albizon/ER4_Accordeur/README.md

# Accordeur de Guitare
## Projet Etude et Réalisation - Semestre 4
## IUT de Nantes - GEII2 - PEI - 2016/2017
### METAYER Simon & BIZON Alexis
### Status : En cours de développement
### Dernière version stable : V1.0
### Version en cours : v2.0

#### Présentation
Le projet consiste à réaliser un accordeur de guitare indiquant par l'intermédiaire de différentes leds si la note est trop haute, juste ou trop basse.</br>
La plateforme retenue pour réaliser cet accordeur est composée d'un SAMD21 de chez Atmel comportant un coeur arm cortex M0+, elle se nomme **SAMD21 Xplained Pro**</br>

####Version 1
La version 1 du projet permet d'accorder des signaux carrés à la note la plus proche avec une erreur définissable à la compilation</br>

####Version 2
La version 2 du projet permet d'accorder une guitare électrique directement reliée au micro-controleur par l'intermédiaire d'un connecteur jack</br>
