albizon/ER4_Accordeur/Code/TP-info2/touches-du-piano.jpg

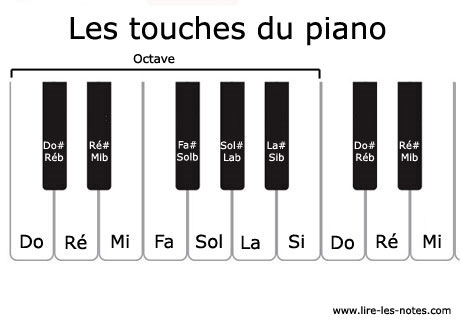
Code/TP-info2/touches-du-piano.jpg
