albizon/ER4_Accordeur/(list of files, drawings)

Other design files:
PCB/AccordeurV2.0.pdsprj
