albizon/ER4_Accordeur/Code/TP-info2/userMemory/src/externalFlashMemory.c

/*
* Accordeur de Guitare
* Authors : METAYER Simon & BIZON Alexis
* Created Date : 02/02/17
* Version : 2.0
*/

#include "externalFlashMemory.h"




/*void initExternalFlash(void)
{
	init_spi(SERCOM_FOR_EXTERNALFLASH, ARGS_FOR_EXTERNALFLASH_INIT);
	initCircuitFlash(0);
}




uint32_t reallocExternalFlash(uint32_t address, uint32_t lastSize, uint32_t newSize)
{
	freeExternalFlash(address, lastSize);
	return allocExternalFlash(newSize);
}*/
