albizon/ER4_Accordeur/Code/TP-info2/userMemory/src/externalRamMemory.c

/*
* Accordeur de Guitare
* Authors : METAYER Simon & BIZON Alexis
* Created Date : 02/02/17
* Version : 2.0
*/

#include "externalRamMemory.h"




/*void initExternalRam(void)
{
	#ifndef USE_SAMD21
	uint32_t args[14] = ARGS_FOR_EXTERNALRAM_INIT;
	initSpi(SERCOM_FOR_EXTERNALRAM, args);
	#endif
	initCircuitRam();
}




uint32_t reallocExternalRam(uint32_t address, uint32_t lastSize, uint32_t newSize)
{
	freeExternalRam(address, lastSize);
	return allocExternalRam(newSize);
}*/
