albizon/ER4_Accordeur/Code/TP-info2/userMemory/src/genericMemory.c

/*
* Accordeur de Guitare
* Authors : METAYER Simon & BIZON Alexis
* Created Date : 02/02/17
* Version : 2.0
*/


#include "genericMemory.h"

/*void _4BytesTo1Byte(uint32_t in, uint8_t *out)
{
	out[0]=in&(0xFF<<0);
	out[1]=in&(0xFF<<8);
	out[2]=in&(0xFF<<16);
	out[3]=in&(0xFF<<24);
}

uint32_t _1BytesTo4Byte(uint8_t *in)
{
	return (in[3]<<24)|(in[2]<<16)|(in[1]<<8)|(in[0]<<0);
}

void writeMemory(uint32_t address, uint32_t val, uint8_t device)
{
	switch(device){
		case USE_INTERNAL_RAM :
			&address = val;
		break;
		case USE_EXTERNAL_FLASH:
			writeExternalFlash_uint32(address, val);
		break;
		case USE_INTERNAL_FLASH:
		
		break;
		case USE_EXTERNAL_RAM:
			writeExternalRam_uint32(address, val);		
		break;
		default :
		
		break;
	}
}

uint32_t readMemory(uint32_t address, uint8_t device)
{
	uint32_t tmp =0;
	
	switch(device){
		case USE_INTERNAL_RAM :
			tmp = &address;
		break;
		case USE_EXTERNAL_FLASH:
		 tmp = readExternalFlash_uint32(address);
		break;
		case USE_INTERNAL_FLASH:
			tmp = 1;
		break;
		case USE_EXTERNAL_RAM:
		 tmp = readExternalRam_uint32(address);
		break;
		default :
		 tmp = 1;
		break;
	}
	
	return tmp;
}

uint32_t allocMemory(uint32_t size, uint8_t device)
{
	uint32_t tmp =0;
	
	switch(device){
		case USE_INTERNAL_RAM :
			tmp = malloc(size*sizeof(uint32_t));
		break;
		case USE_EXTERNAL_FLASH:
			tmp = allocExternalFlash(size);
		break;
		case USE_INTERNAL_FLASH:
			tmp = 1;
		break;
		case USE_EXTERNAL_RAM:
			tmp = allocExternalRam(size);
		break;
		default :
			tmp = 1;
		break;
	}
	
	return tmp;
}

void freeMemory(uint32_t address, uint32_t size, uint8_t device)
{
	switch(device){
		case USE_INTERNAL_RAM :
			free(address);
		break;
		case USE_EXTERNAL_FLASH:
			freeExternalFlash(address, size);
		break;
		case USE_INTERNAL_FLASH:
		
		break;
		case USE_EXTERNAL_RAM:
			freeExternalRam(address, size);
		break;
		default :
		
		break;
	}
}

uint32_t reallocMemory(uint32_t address, uint32_t lastSize, uint32_t newSize, uint8_t device)
{
	uint32_t tmp =0;
	
	switch(device){
		case USE_INTERNAL_RAM :
			tmp = realloc(address, newSize*sizeof(uint32_t));
		break;
		case USE_EXTERNAL_FLASH:
			tmp = reallocExternalFlash(address, lastSize, newSize);
		break;
		case USE_INTERNAL_FLASH:
			tmp = 1;
		break;
		case USE_EXTERNAL_RAM:
			tmp = reallocExternalRam(address, lastSize, newSize);
		break;
		default :
			tmp = 1;
		break;
	}
	
	return tmp;
}*/
