albizon/ER4_Accordeur/Code/TP-info2/userLibraries/include/fftDescribe.h

/*
* Accordeur de Guitare
* Authors : METAYER Simon & BIZON Alexis
* Created Date : 25/01/17
* Version : 2.0
*/



#ifndef __FFTDESCRIBE_H__
#define __FFTDESCRIBE_H__

#include "define.h"
#include "fftDescribe.h"
#include "userEnvelope.h"
#include "userComplexArray.h"

/*
* Overview : Sépare les enveloppes spectrales présentent dans une fft en fonction de l'argument présent sur chaques raies
* Author : BIZON Alexis
* Params :  -const float *mod -> module du nombre complexe à traiter
*			-const float *arg -> argument du nombre complexe à traiter
*			-float **envs -> tableau des enveloppes différenciées par leur argument
* Return : none
*/
//void extractEnveloppes(const struct floatSingleArray *mod, const struct floatSingleArray *arg, struct floatDoubleArray **envs);

void extractOneEnvelope(userComplexArray *complexVect, userEnvelope *env, uint8_t nbHarm, float deltaFreq);



#endif
