albizon/ER4_Accordeur/Code/TP-info2/userLibraries/src/freq.c

/*
* Accordeur de Guitare
* Authors : METAYER Simon & BIZON Alexis
* Created Date : 23/01/17
* Version : 1.0
*/


#include "define.h"
#include "freq.h"

float __freq;//Variable globale contenant la dernière fréquence mesurée



/*
* Overview : Initialisation du fréquencemètre
* Author : BIZON Alexis
* Params : none
* Return : none
*/
void initFreq()
{
	// EIC pour la détection du passage en zéro de notre signal sinusoidal
	pinMode(PORTB, 15, INPUT_PULLUP);//configuration de pb 15 en entrée
	pinMux(PORTB, 15, CONFIG_A);// pb 15 sur l'eic
	EICInitClock(F32KHZ);// initialisation de la source d'horloge pour l'eic à 32 kHz
	EICConfig(15,1,RISING);// configuration de l'eic 15 en detection de niveau bas avec filtre
	NVIC_EnableIRQ(EIC_IRQn);// acivation des interuptions sur EIC
	
	// TIMER TC3 à 1MHz
	TCinitClock(F1MHZ,3); // Initialisation de l'horloge à 1MHz pour le timer TC3
	TC3->COUNT16.CTRLA.reg= (0x3<<8); // intialisation d'un prescaler de '011' soit une division par 8 donc 1/8 de Mhz
	TC3->COUNT16.CTRLBSET.reg=0x0; // Initialisation du timer en incrémentation
	TC3->COUNT16.COUNT.reg=0; // Chargement du compteur
	TC3->COUNT16.INTFLAG.reg=0x1; // Validation de l'overflow
	TC3->COUNT16.CTRLA.reg |=2; // Démarrage du timer
}


/*
* Overview : Fonction appelée par les interuptions sur l'EIC
* Author : BIZON Alexis
* Params : none
* Return : none
*/
void EIC_Handler()
{
	NVIC_DisableIRQ(EIC_IRQn);// désacivation des interuptions sur EIC
	static char countOn;//Variable static définnissant si l'on est entrain de compter
	if((EIC->INTFLAG.reg & (1<<15)) && (!countOn)) // Si on ne compte pas
	{
		countOn =1;//Alors maintenant on compte
		TC3->COUNT16.COUNT.reg=0; // RAZ du compteur
		EIC->INTFLAG.reg |= 1<<15; // RAZ de la détection EIC
	}
	else if((EIC->INTFLAG.reg & (1<<15)) && (countOn)) // Si on était en train de compter
	{
		countOn =0;//Alors maintenant on ne compte plus
		__freq = (float)(1/((TC3->COUNT16.COUNT.reg)*(0.000008))) ; // 1/(x*8us) 
		EIC->INTFLAG.reg |= 1<<15; // RAZ de la détection EIC
	}
	NVIC_EnableIRQ(EIC_IRQn);// acivation des interuptions sur EIC
}


/*
* Overview : Récupération de la dèrnière valeur de fréquence mesurée par le fréquencemètre
* Author : BIZON Alexis
* Params : none
* Return : float : freq -> valleure de la fréquence en Hz
*/
float getFreq()
{
	return __freq;//Renvoie la valeur de la variable globale contenant la fréquence
}
