albizon/ER4_Accordeur/(commit log)

2017-01-24 Ajout des fichiers du projet déja existants
2017-01-24 Create define_notes.h
    fichier contenant tous les define relatifs aux notes.
2017-01-24 ajout du include de define_note.h
2017-01-24 include de math.h
2017-01-25 affichage led mis en fonction dans le diplay, projet réparé, compile bien et foncitonne parfaitement
2017-01-25 modif plateforme
2017-01-29 gestion dynamique de la ram
2017-01-30 Commentaire de define_note.h
2017-01-30 inclusion des fichiers de la v2.0
2017-01-30 essai fft ... fail
    [fft.c, fftDescribe.c, instruments.c]
2017-01-31 realloc de floatArray
2017-02-01 tableaux de float
2017-02-01 Implémentation d'une FFT digne de ce nom
2017-02-02 définition de userComplexArray
2017-02-02 réparation des erreurs
2017-02-02 modif flash & spi
2017-02-04 ajout ressources revue de projet
2017-02-05 spi samd21
2017-02-08 correction déréférencement de pointeur samd21SPI
    [samd21Spi.c]
2017-03-08 Ajout du PCB au projet
    [AccordeurV2.0.pdsprj]
2017-03-08 MAJ PCB
    [AccordeurV2.0.pdsprj]
2017-03-20 MAJ PCB + CR
    [AccordeurV2.0.pdsprj]
2017-03-24 switch project
2017-03-26 addition direct adc
